CITI-USP/ControleM/README.md

ControleM
=========

É um emulador de joystick analógico de cadeira de rodas motorizada controlado por Smartphone.

| Vídeo de demonstração - protótipo com controle proporcional (Multi direcional) |
|---------|
|Vídeo de demonstração proprocional (https://www.youtube.com/watch?v=2mQoy-6fy2M)|

| Vídeo de demonstração - protótipo com controle discreto (4 direções) |
|---------|
|Vídeo de demonstração discreto (https://www.youtube.com/watch?v=nm2pQ9PgypI)|

Este projeto foi apresentado no TOM "Tikkun Olam Makers" 2014:

Vídeo do TOM 2014 (https://youtu.be/WmIyEbNxP3A)

O joystick analógico de cadeira de rodas possuem um comportamento padrão, mais informações em  [Interfaces de entrada para Cadeira de rodas motorizada](http://marchanjo.blogspot.com.br/2013/07/interface-de-entrada-para-cadeira-de.html).

A essência para emular um joystick é produzir um sinal de referência de 6v e dois (x e y) sinais analógicos reais com 6v e variação de 10% de alimentação (1,2v para alimentação de 12v) para mais ou para menos, ou seja de 4,8v até 7,2v. Abaixo a figura de um joystick analógico padrão:

Joystick analógico JC200

*Joystick JC200 (Part Number: JC200BS1K1Y de 12V ). Fonte: [Farnell](http://www.farnellnewark.com.br/chavetipojoystick12vdc,product,01M8005,4614452.aspx)*

Como funciona
-------------
Uma [Arduino Due](http://arduino.cc/en/Main/ArduinoBoardDue) com um circuito adicional é alimentado pela cadeira de rodas motorizada (12v 100mA), como se fosse um joystick analógio padrão. A Arduino Due possui duas saídas DAC ((digital to analog) de 3,3v (Arduino Due  trabalha com 3,3v) com amplificadores operacionais esta saídas são elevadas para 12v, sendo que são programadas para ficarem no meio da escala (6v) e variar 1,2v para mais ou para menos.

Um módulo Bluetooth serial provê a comunicação remota sem fio, através de um protocolo simples e robusto são recebidos os dados necessário para controlar as saídas DAC. O módulo Bluetooth teve a velocidade ajustada para 115200 bps com o comando: AT+BAUD8 mais informações: [AT command mode of HC-05 and HC-06 Bluetooth module] ( http://www.instructables.com/id/AT-command-mode-of-HC-05-Bluetooth-module/?ALLSTEPS)

A figura abaixo apresenta o circuto necessário:

*Esquemático:*
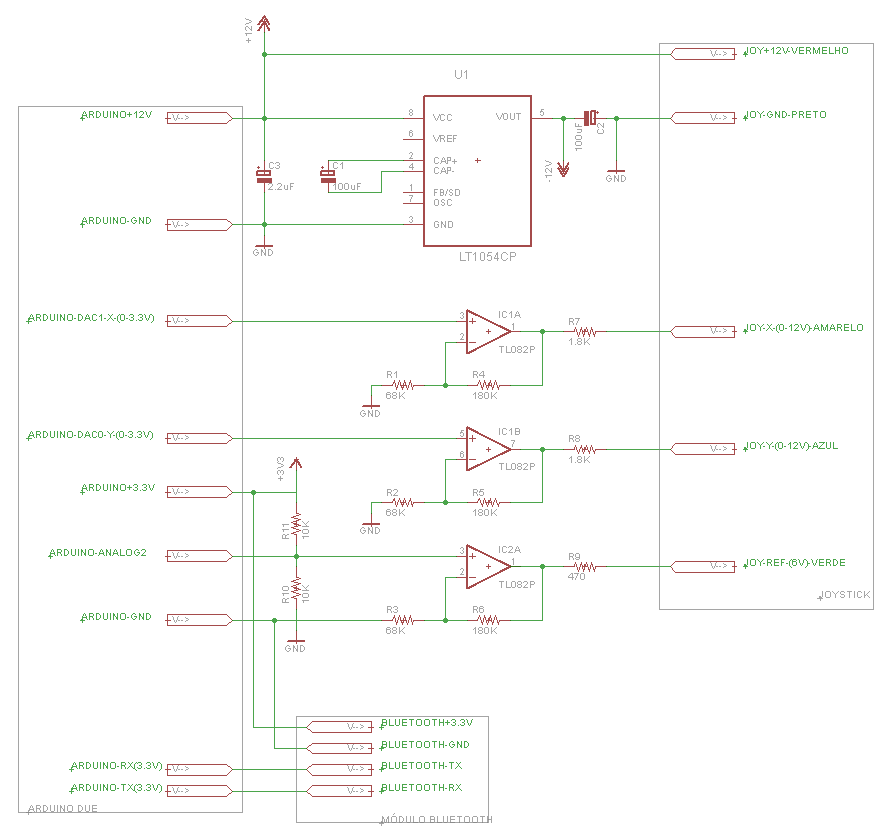
[picture p1: Hardware/ControleM.png]
Esquemático


*Arduino Due e Shield:*
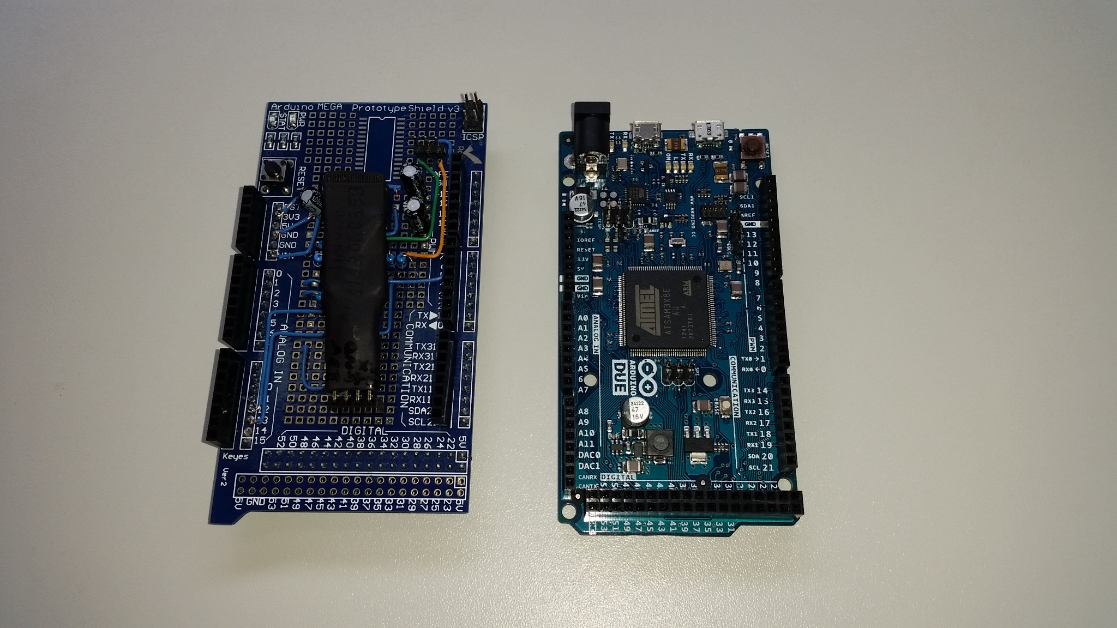
[picture p2: Doc/ArduinoDueShield.jpg]
Arduino Due e Shield


*Arduino Due e Shield montada:*
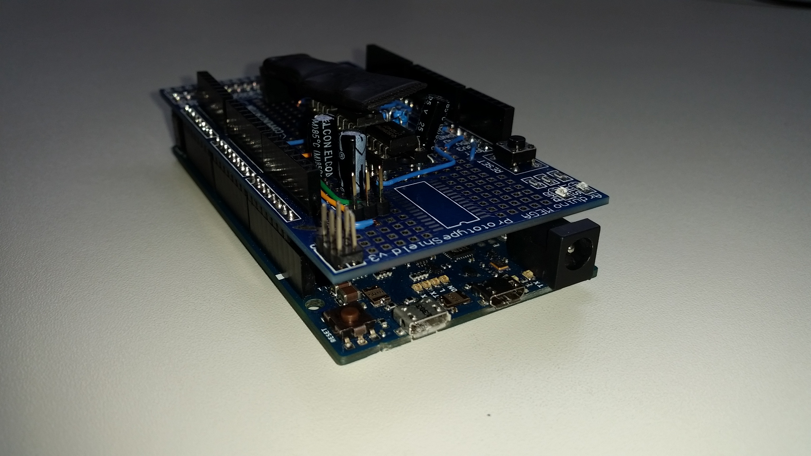
[picture p3: Doc/ArduinoDueShieldMontadas1.jpg]
Arduino Due e Shield montada


Protocolo de comunicação
------------------------

A placa e o smartphone se conectam por meio de Bluetooth.

O smartphone deve enviar pacotes seriais de 8 bytes seguindo o protocolo abaixo:

|Sequência | Descrição |
|---|---|
|Byte 0 | Início da sequência (*) |
|Byte 1 | Coordenada X - byte mais significativo  |
|Byte 2 | Coordenada X - byte menos significativo |
|Byte 3 | Coordenada Y - byte mais significativo  |
|Byte 4 | Coordenada Y - byte menos significativo |
|Byte 5 | Flag register - primeiro byte |
|Byte 6 | Flag register - segundo byte |
|Byte 7 | Número de sequência |
|Byte 8 | Byte de verificação - Checksum |

Ao reconhecer o valor do byte 0 como o caracter *, o firmware inicia a sequência de leitura do pacote.

Os bytes 1 e 2 contém a coordenada X do joystick, um valor de 0 a 4093.

Os bytes 3 e 4 contém a coordenada Y do joystick, um valor de 0 a 4093.

Os bytes 5 e 6 são um conjunto de bits para enviar informações genéricas do smartphone para a App. No exemplo atual, apenas o último bit do byte 6 é usado, para informar o modo de operação do firmware.

O byte 7 é um byte que contém o número de sequência do pacote enviado, e é usado para verificar se um mesmo pacote não foi enviado mais de uma vez por problema de conexão entre placa e smartphone.

O byte 8 é um byte de verificação, que contém a soma dos bytes anteriores (exceto o byte 0), e é usado para confirmar que não houve corrupção do pacote enviado.

Mapa do projeto
---------------
* **/Firmware** - Código Arduino
* **/Hardware** - Arquivos de design, formato Eagle
* **/App** - Código da aplicação Android
* **/Doc** - Arquivos adicionais usados no Read Me
* **/Bin** - Arquivos binários

Licença
-------
O hardware e o software estão disponiveis em [Creative Commons Attribution-ShareAlike 4.0 International License.](http://creativecommons.org/licenses/by-sa/4.0/)

The hardware and the software are released under [Creative Commons Attribution-ShareAlike 4.0 International License.](http://creativecommons.org/licenses/by-sa/4.0/)

Distribuido como está, nenhuma garantia é dada.

Distributed as-is; no warranty is given.
