CITI-USP/ControleM/Doc/ArduinoDueSheildMontadas 2.jpg

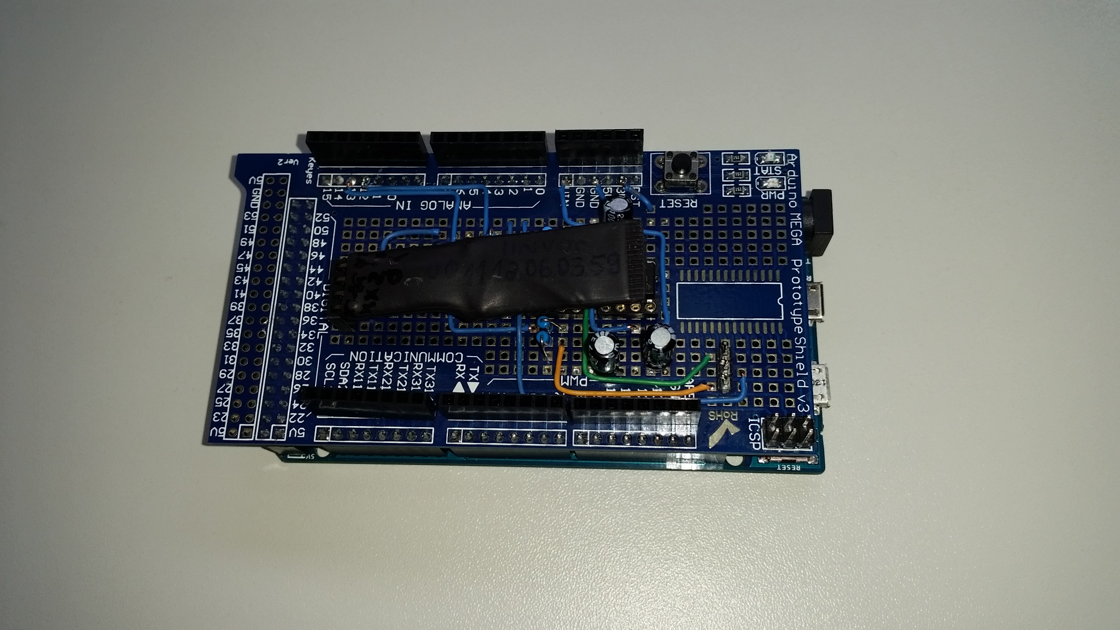
Doc/ArduinoDueSheildMontadas 2.jpg
