CITI-USP/ControleM/Hardware/ControleM.sch

## EAGLE design Hardware/ControleM.sch (2015-02-11)

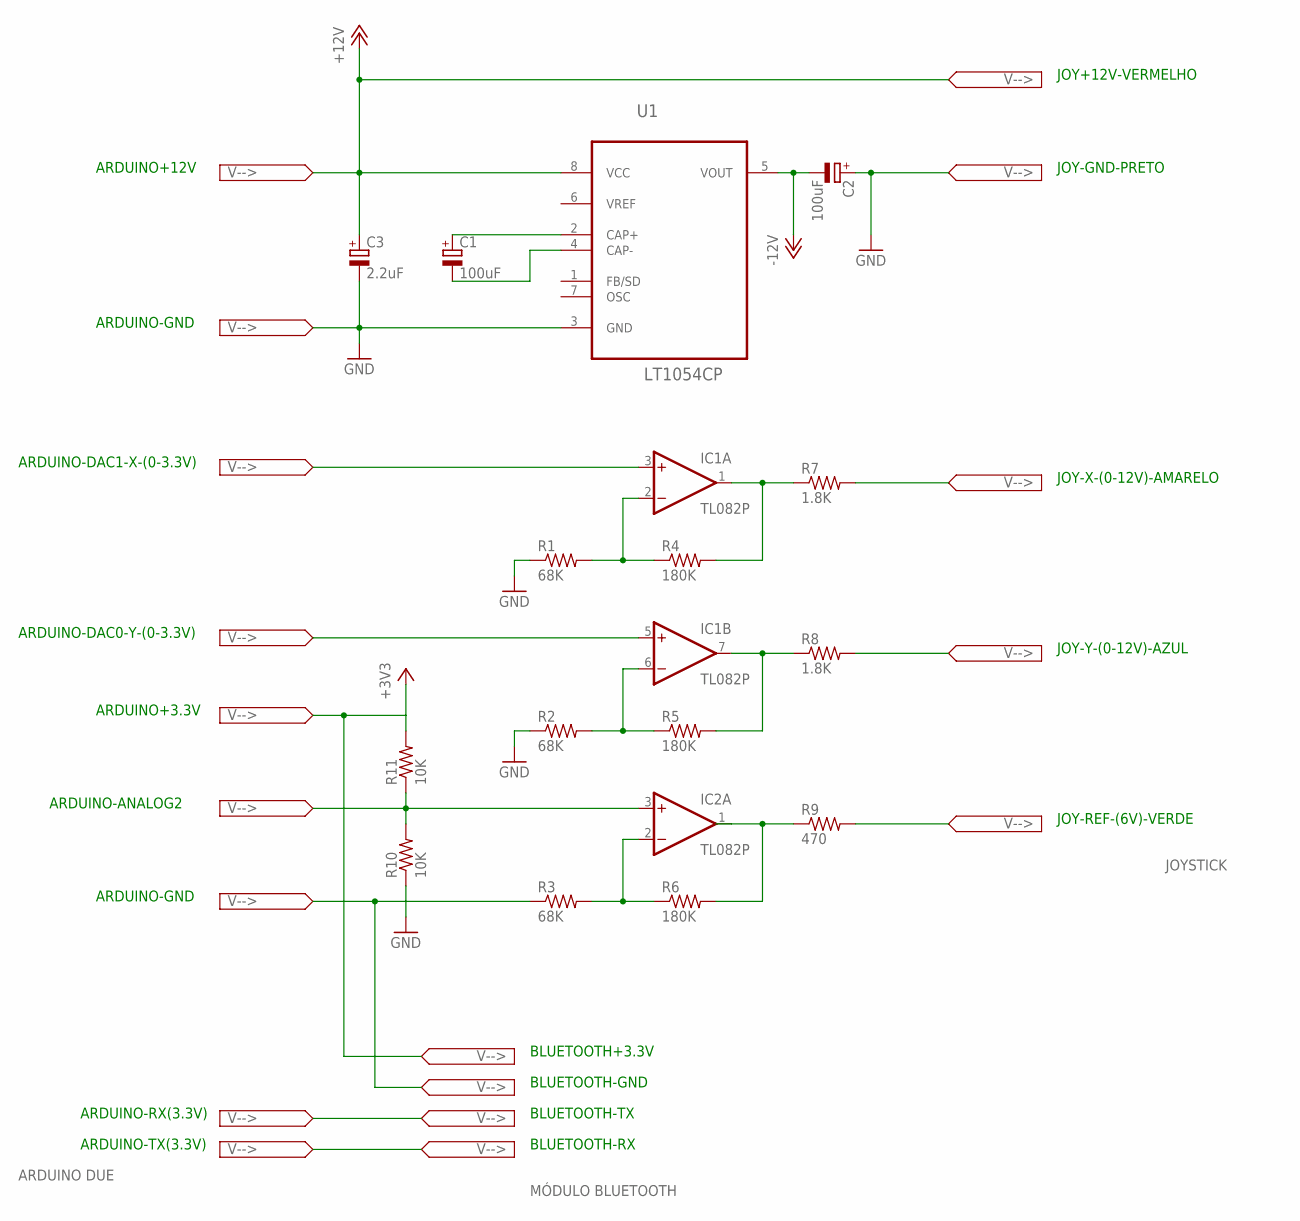
[picture p5: schematic ControleM.sch]

Parts:
C1, C2: 100uF; E2,5-6
C3: 2.2uF; E2,5-6
IC1, IC2: TL082P; DIL08
R1, R2, R3: 68K; 0207/12
R4, R5, R6: 180K; 0207/12
R7, R8: 1.8K; 0207/12
R9: 470; 0207/12
R10, R11: 10K; 0207/12
U1: LT1054CP; DIP254P762X508-8

Connections:
+3V3: R11.2
+12V: C3.+, U1.8 (VCC)
-12V: C2.-, U1.5 (VOUT)
GND: C2.+, C3.-, R1.1, R2.1, R3.1, R10.1, U1.3 (GND)
unnamed: C1.+, U1.2 (CAP+)
unnamed: C1.-, U1.4 (CAP-)
unnamed: IC1.2 (-IN), R1.2, R4.1
unnamed: IC1.6 (-IN), R2.2, R5.1
unnamed: IC2.1 (OUT), R6.2, R9.1
unnamed: IC1.1 (OUT), R4.2, R7.1
unnamed: IC1.7 (OUT), R5.2, R8.1
unnamed: IC2.3 (+IN), R10.2, R11.1
unnamed: IC2.2 (-IN), R3.2, R6.1

Notes on the sheet:
ARDUINO+12V
ARDUINO-GND
ARDUINO-DAC1-X-(0-3.3V)
ARDUINO-DAC0-Y-(0-3.3V)
ARDUINO+3.3V
JOY-X-(0-12V)-AMARELO
JOY-Y-(0-12V)-AZUL
JOY-REF-(6V)-VERDE
ARDUINO-RX(3.3V)
ARDUINO-TX(3.3V)
BLUETOOTH-RX
BLUETOOTH-TX
BLUETOOTH-GND
BLUETOOTH+3.3V
JOY-GND-PRETO
JOY+12V-VERMELHO
ARDUINO DUE
MÓDULO BLUETOOTH
JOYSTICK
ARDUINO-ANALOG2
