CITI-USP/ControleM/(commit log)

2014-11-04 Esquemático para o Controle Analógico
    [ControleM.sch]
2014-11-04 Tratamento do CheckSum e baud rate de 115200 bps
    Ajustes no protocolo para tratar o Checksum e mudança no boudrate devido
    a nova configuração módulo Bluetooth, com 9600 bps muitos pacotes eram
    perdidos. Com 115200 bps ficou estavel, não identificamos pacotes
    perdidos.
2014-11-05 refatoração: move classes de comunicação Bluetooth para novos arquivos
2014-11-07 Tratamento da sequência de pacotes
    Nesta versão, um pacote com o mesmo número de sequência o pacote
    anterior é tratado como erro e considerado inválido
2014-11-18 Substituição dos links das imagens
    Mudei os links das imagens para as mesmas agora contidas no próprio GitHub.
2014-11-26 Firmware no diretório padrão da IDE arduino
2015-02-11 Correção do fundo de escala no DAC e REF retorno
    A variação máxima do DAC foi ajustada para chegar em +ou-10% de VCC
    sobre o meio da escala. Foi necessário devido a característica do DAC da
    Arduino Due.
    Outra alteração foi colher o sinal de REF (metade de 3,3v ) do divisor
    de tensão e realimentar no Analog2 de maneira a garantir que o centro da
    escala no DAC reflita a metade da tensão medida.
    [ControleM.sch]
2015-02-11 Retirada do binarios do código Arduino
2015-02-11 Mais instruções sobre a mudança de Baud Rate
2020-06-04 Atualizações
    Atualização para funcionar no Android Studio 3.5
    Fixar a operação em portrait: android:screenOrientation="portrait"
